samuelWilliams99/SmartKnob/electronics/view_base/view_base.kicad_pcb

## KiCad design electronics/view_base/view_base.kicad_pcb (2026-04-20)

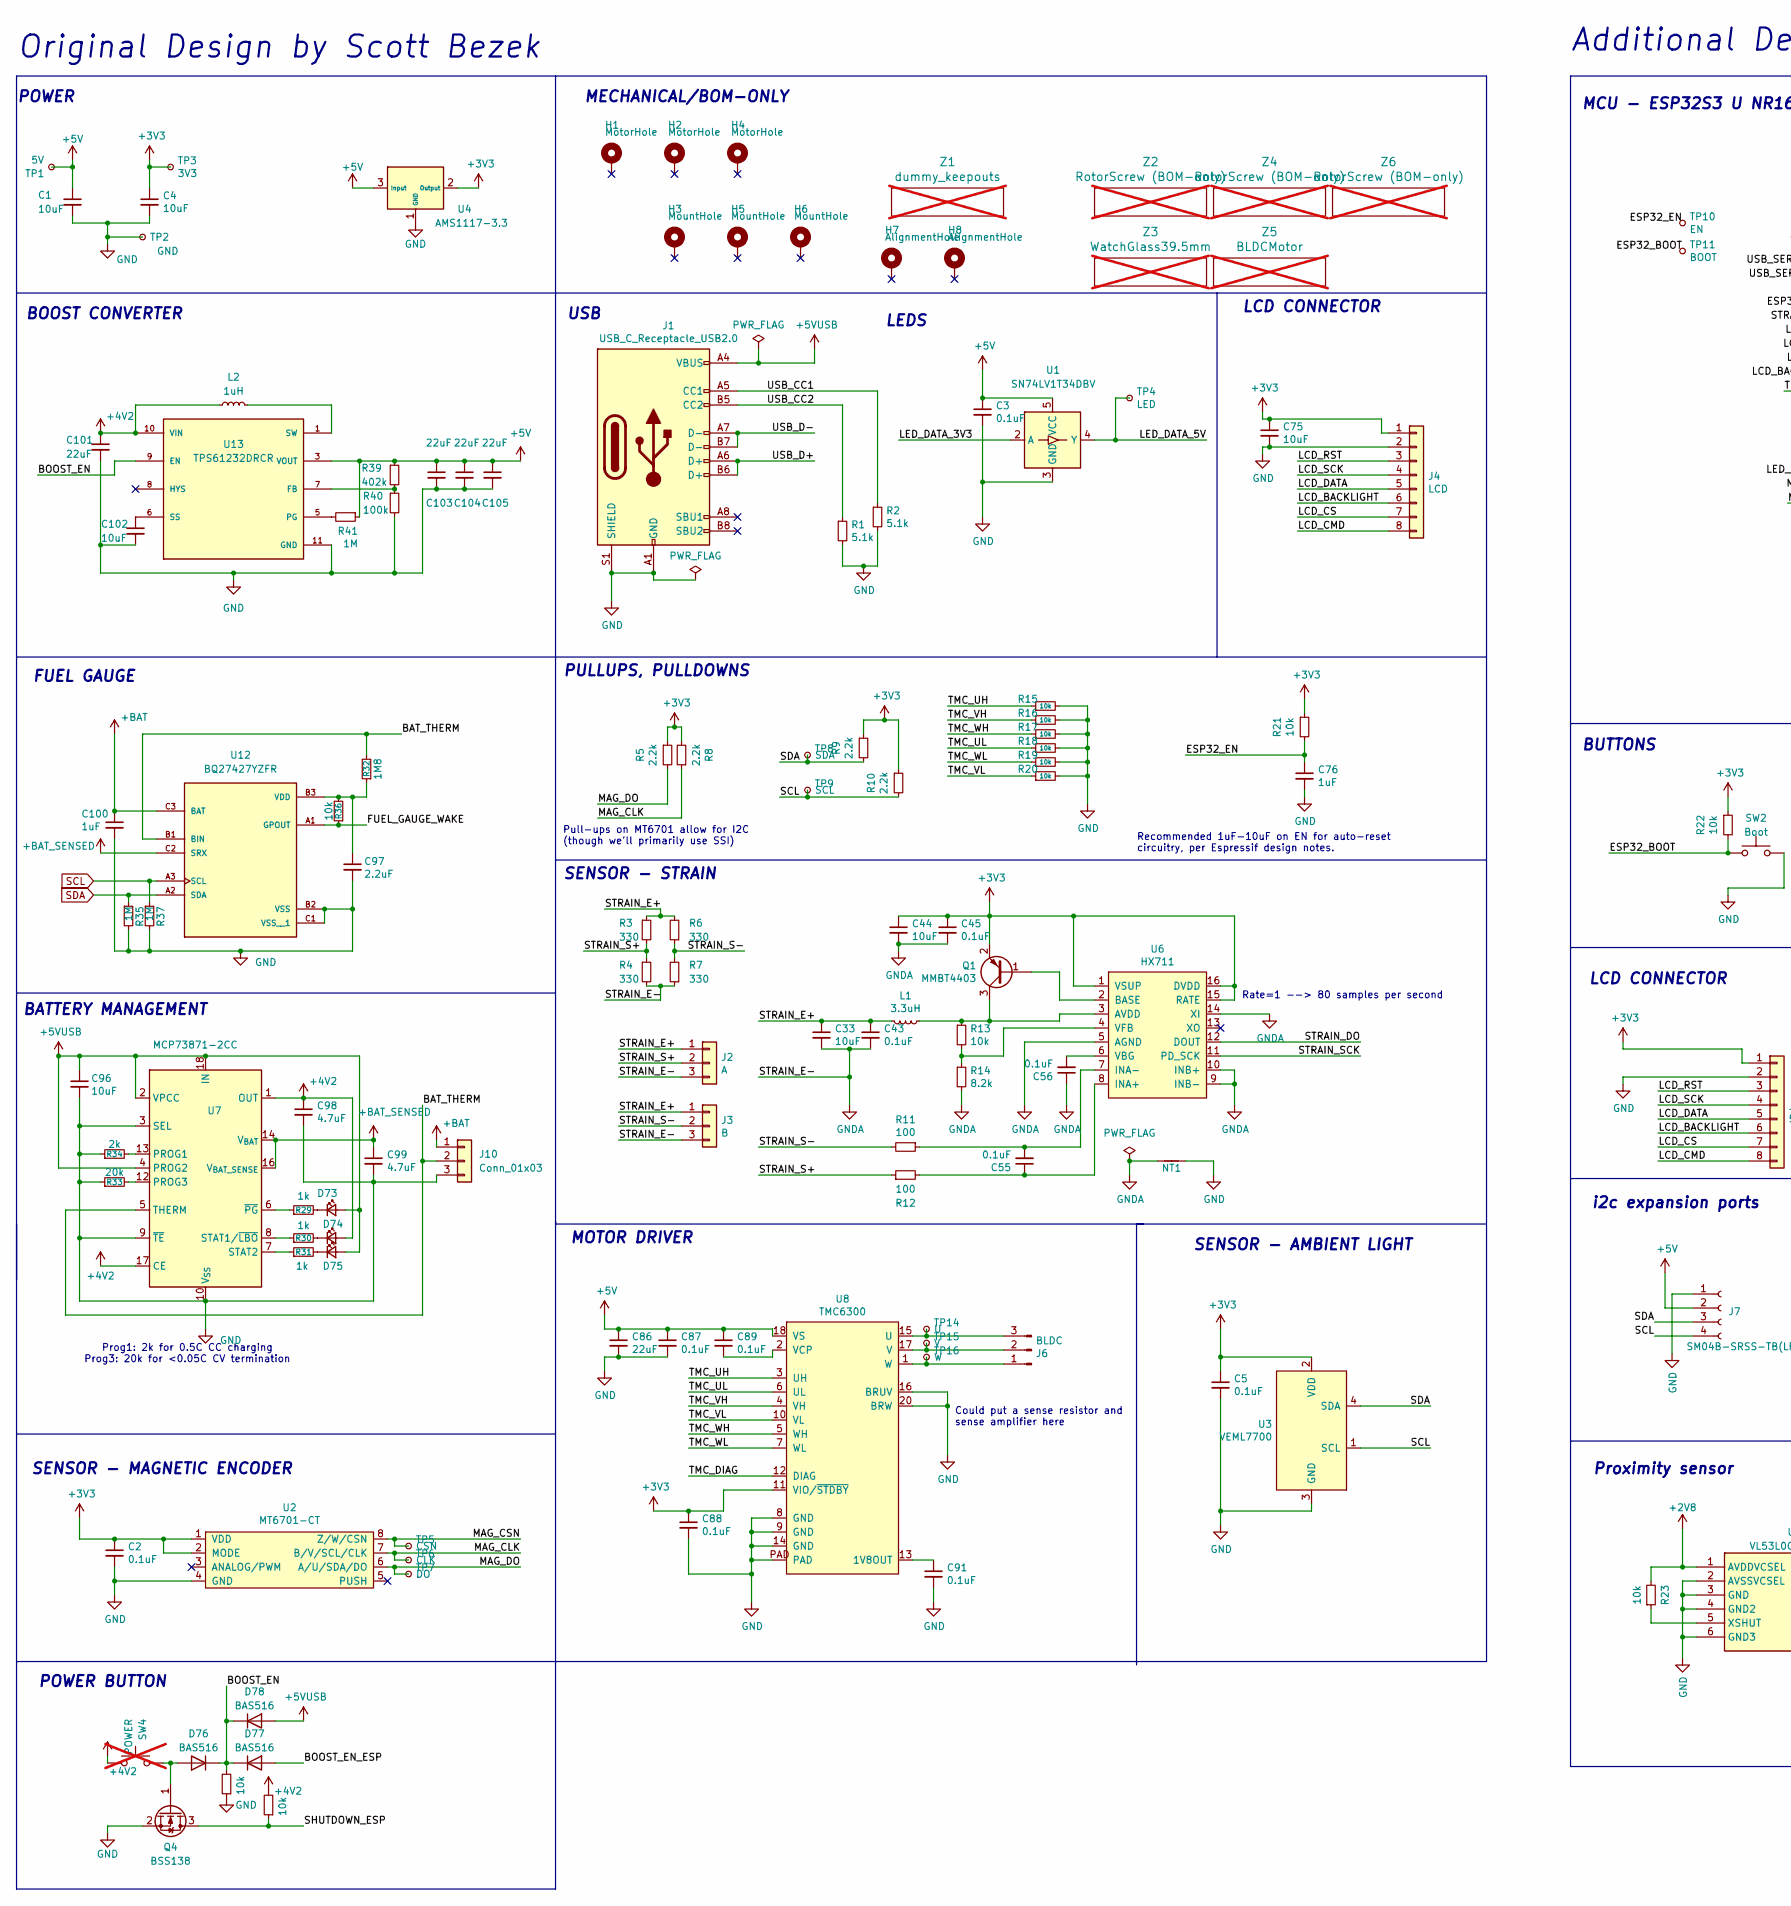
[picture p1: schematic view_base.kicad_sch, SmartKnob DevKit Base, part in row 1, column 1]

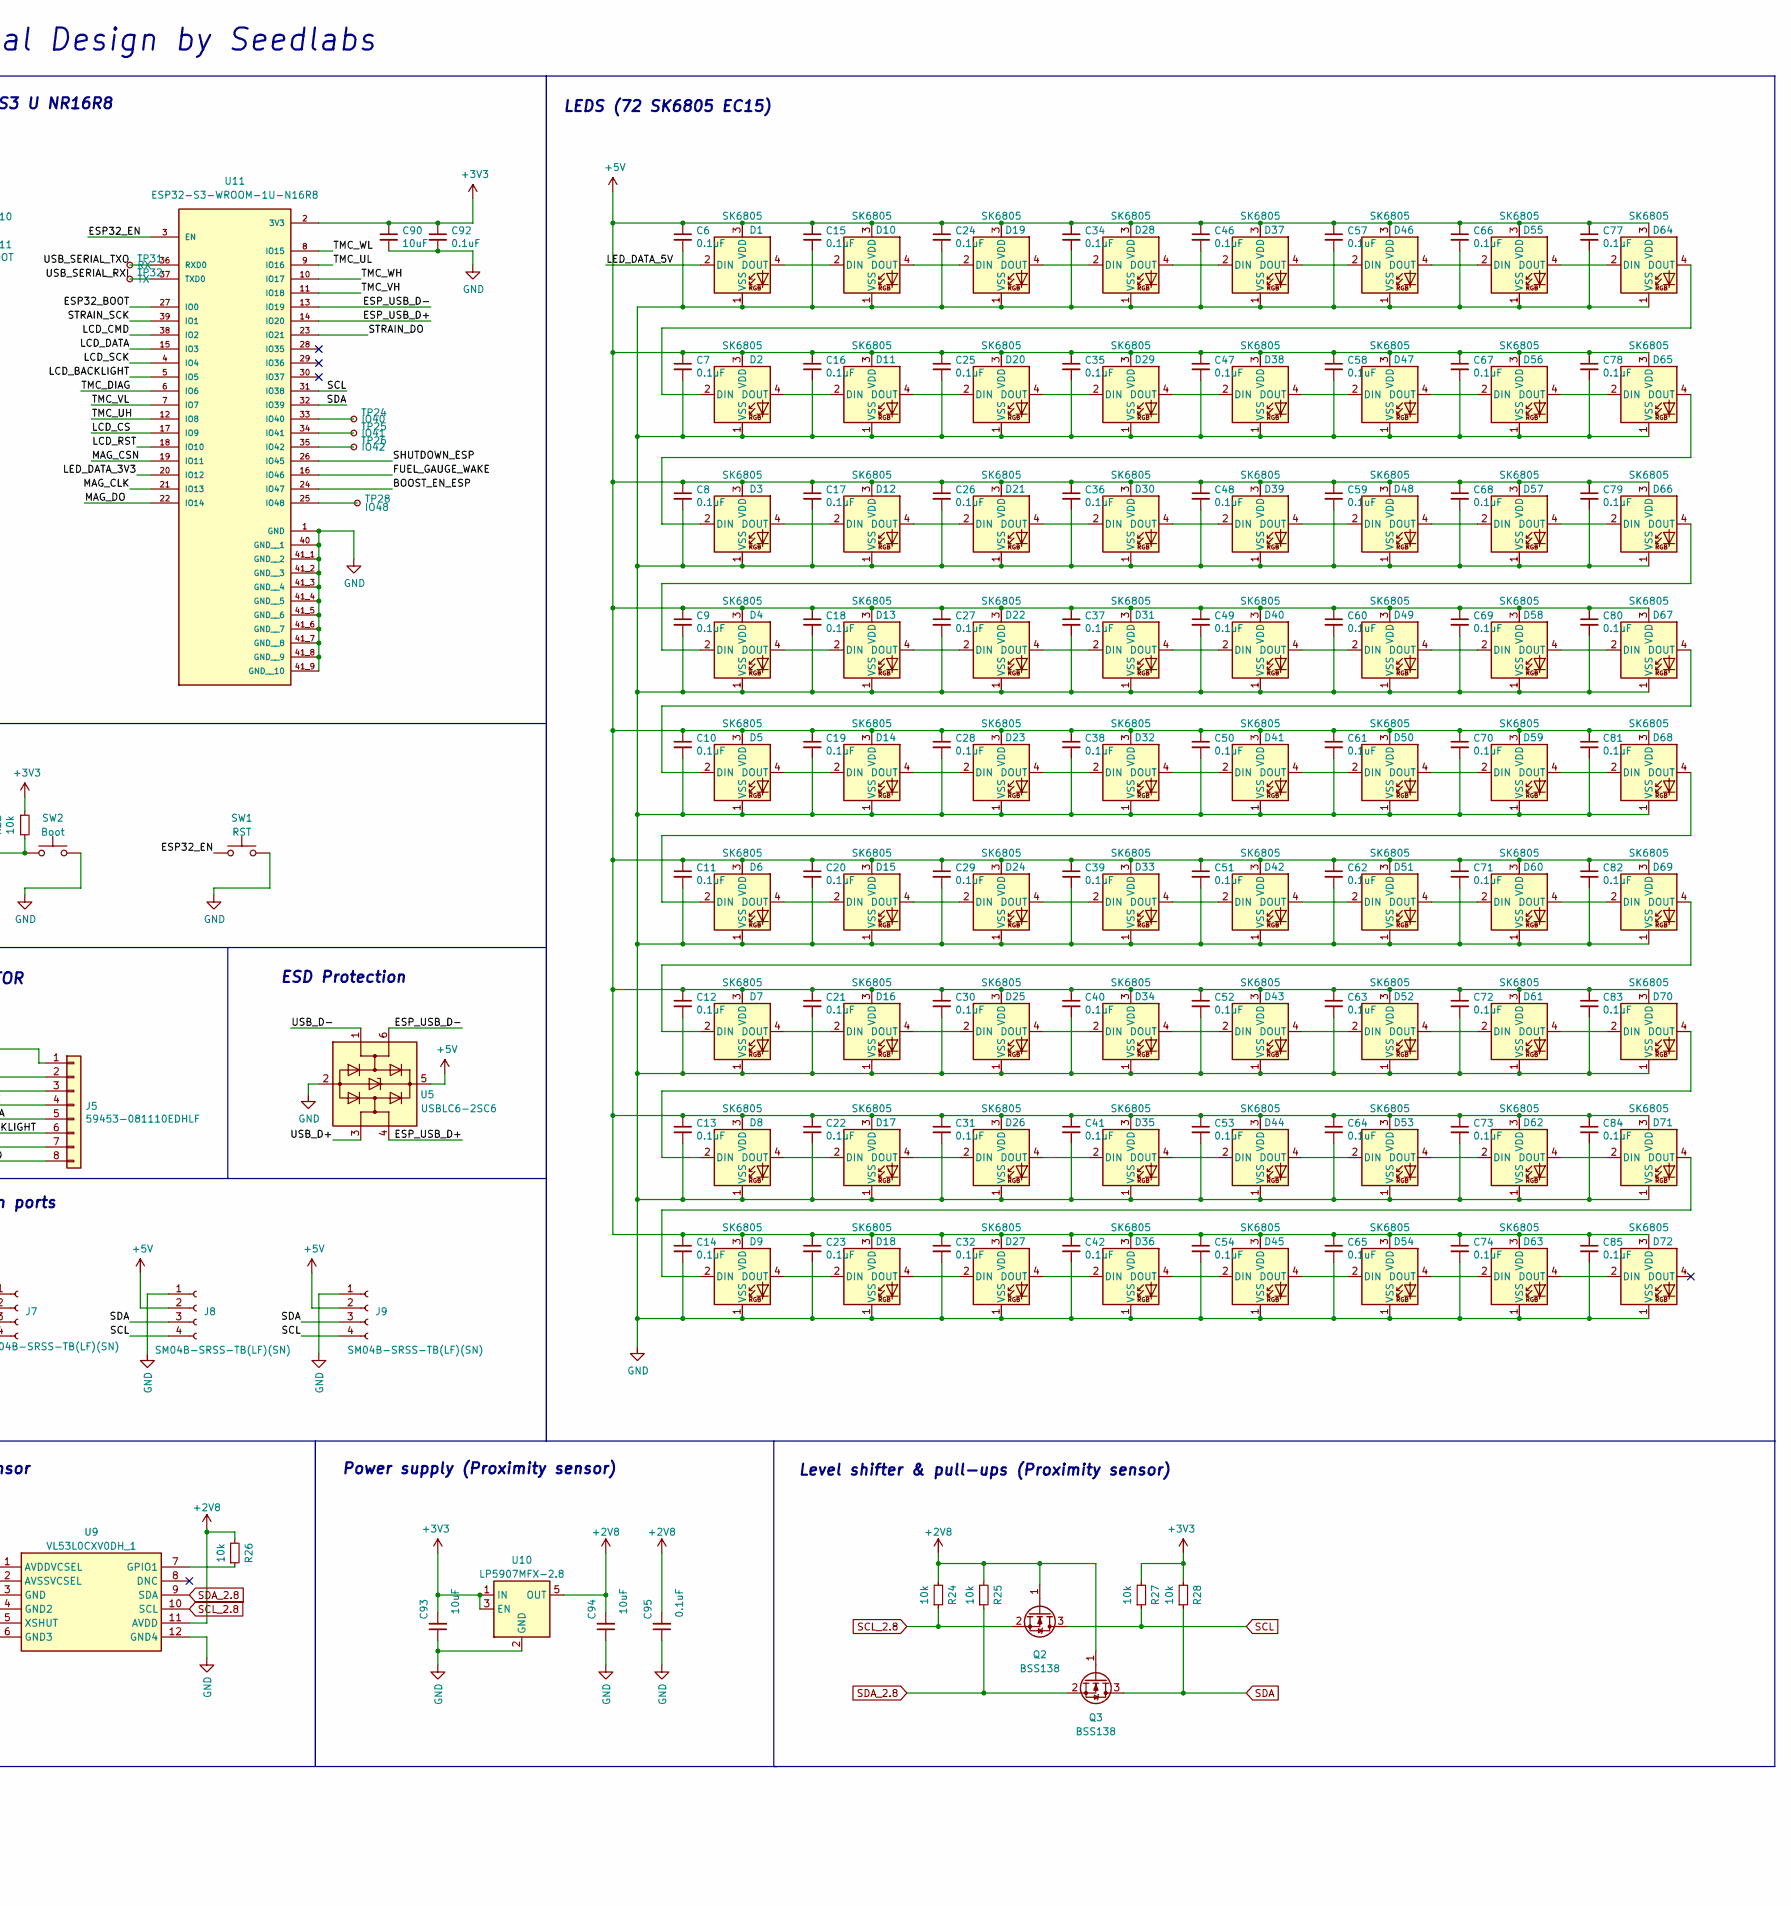
[picture p2: schematic view_base.kicad_sch, SmartKnob DevKit Base, part in row 1, column 2]

Parts:
C1, C4, C33, C44, C75, C90, C96: 10uF; C_0805_2012Metric; LCSC C15850
C2, C3, C5, C43, C45, C55, C56, C87, C88, C89, C91, C92, C95: 0.1uF; C_0603_1608Metric; LCSC C1591
C6, C7, C8, C9, C10, C11, C12, C13, C14, C15, C16, C17, C18, C19, C20, C21, C22, C23, C24, C25, C26, C27, C28, C29, C30, C31, C32, C34, C35, C36, C37, C38, C39, C40, C41, C42, C46, C47, C48, C49, C50, C51, C52, C53, C54, C57, C58, C59, C60, C61, C62, C63, C64, C65, C66, C67, C68, C69, C70, C71, C72, C73, C74, C77, C78, C79, C80, C81, C82, C83, C84, C85: 0.1uF; C_0402_1005Metric; LCSC C83056
C76: 1uF; C_0603_1608Metric; Mouser 187-CL10A105KA8NNNC
C86, C101, C103, C104, C105: 22uF; C_0805_2012Metric; LCSC C98190
C93, C94, C102: 10uF; C_0603_1608Metric; LCSC C38898
C97: 2.2uF; C_0805_2012Metric; LCSC C2228260
C98, C99: 4.7uF; C_0805_2012Metric; LCSC C1779
C100: 1uF; C_0805_2012Metric; LCSC C520051
D1, D2, D3, D4, D5, D6, D7, D8, D9, D10, D11, D12, D13, D14, D15, D16, D17, D18, D19, D20, D21, D22, D23, D24, D25, D26, D27, D28, D29, D30, D31, D32, D33, D34, D35, D36, D37, D38, D39, D40, D41, D42, D43, D44, D45, D46, D47, D48, D49, D50, D51, D52, D53, D54, D55, D56, D57, D58, D59, D60, D61, D62, D63, D64, D65, D66, D67, D68, D69, D70, D71, D72: SK6805; LED_SK6812_EC15_1.5x1.5mm; LCSC C2890035
D73: Blue; LED_0805_2012Metric; LCSC C2293
D74: Green; LED_0805_2012Metric; LCSC C2297
D75: Red; LED_0805_2012Metric; LCSC C2295
D76, D77, D78: BAS516; D_SOD-523; LCSC C10037
H1, H2, H4: MotorHole; MountingHole_M1.6; LCSC C2931389
H3, H5, H6: MountHole; MountingHole_2.2mm_M2_ISO7380_Pad_NonVirtual; LCSC C2911210 or C2911532 (screw), C2961595 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
H7, H8: AlignmentHole; MountingHole_2.2mm_M2_ISO7380_Pad_NonVirtual
J1: USB_C_Receptacle_USB2.0; USB4510_NoPaste; LCSC C428463
J2: A; SolderPads_2mm_3_STRAIN
J3: B; SolderPads_2mm_3_STRAIN
J4: LCD; SolderPads_2mm_8
J5: 59453-081110EDHLF; Amphenol FCI FPC 8 pin 0.5 pitch; Mouser 649-59453081110EDHLF
J6: BLDC; 532610371; LCSC C293630
J7, J8, J9: SM04B-SRSS-TB(LF)(SN); JST_SH_SM04B-SRSS-TB_1x04-1MP_P1.00mm_Horizontal; Mouser 485-4208
J10: Conn_01x03; JST_PH_S3B-PH-K_1x03_P2.00mm_Horizontal; LCSC C545716
L1: 3.3uH; L_0805_2012Metric; LCSC C307744
L2: 1uH; L_0603_1608Metric
NT1: NetTie_2; NetTie-2_SMD_Pad0.5mm
Q1: MMBT4403; SOT-23; LCSC C78864
Q2, Q3, Q4: BSS138; SOT-23; LCSC C2874697
R1, R2: 5.1k; R_0603_1608Metric; LCSC C105580
R3, R4, R6, R7: 330; R_2512_6332Metric; LCSC C19866
R5, R8, R9, R10: 2.2k; R_0603_1608Metric; LCSC C4190
R11, R12: 100; R_0603_1608Metric; LCSC C319953
R13, R15, R16, R17, R18, R19, R20, R21, R22, R23, R24, R25, R26, R27, R28, R36, R42, R43: 10k; R_0603_1608Metric; LCSC C98220
R14: 8.2k; R_0603_1608Metric; LCSC C114637
R29, R30, R31: 1k; R_0603_1608Metric; LCSC C21190
R32: 1M8; R_0603_1608Metric; LCSC C22356606
R33: 20k; R_0805_2012Metric_Pad1.20x1.40mm_HandSolder; LCSC C4328
R34: 2k; R_0805_2012Metric_Pad1.20x1.40mm_HandSolder; LCSC C17604
R35, R37, R41: 1M; R_0603_1608Metric; LCSC C22935
R39: 402k; R_0603_1608Metric; LCSC C23048
R40: 100k; R_0603_1608Metric; LCSC C25803
SW1: RST; SW_SPST_PTS810; LCSC C116501
SW2: Boot; SW_SPST_PTS810; LCSC C116501
SW4: POWER; TestPoint_2Pads_Pitch2.54mm_Drill0.8mm; LCSC C116501; not fitted
TP1: 5V; TestPoint_Pad_D2.0mm
TP2: GND; TestPoint_Pad_D2.0mm
TP3: 3V3; TestPoint_Pad_D2.0mm
TP4: LED; TestPoint_Pad_D2.0mm
TP5: CSN; TestPoint_Pad_D2.0mm
TP6: CLK; TestPoint_Pad_D2.0mm
TP7: DO; TestPoint_Pad_D2.0mm
TP8: SDA; TestPoint_Pad_D2.0mm
TP9: SCL; TestPoint_Pad_D2.0mm
TP10: EN; TestPoint_Pad_D2.0mm
TP11: BOOT; TestPoint_Pad_D2.0mm
TP14: U; TestPoint_Pad_D2.0mm
TP15: V; TestPoint_Pad_D2.0mm
TP16: W; TestPoint_Pad_D2.0mm
TP24: IO40; TestPoint_Pad_D2.0mm
TP25: IO41; TestPoint_Pad_D2.0mm
TP26: IO42; TestPoint_Pad_D2.0mm
TP28: IO48; TestPoint_Pad_D2.0mm
TP31: RX; TestPoint_Pad_D2.0mm
TP32: TX; TestPoint_Pad_D2.0mm
U1: SN74LV1T34DBV; SOT-23-5; LCSC C100024
U2: MT6701-CT; SOIC-8_3.9x4.9mm_P1.27mm; LCSC C2856764
U3: VEML7700; VEML7700-TOP; Digikey VEML7700-TT
U4: AMS1117-3.3; SOT-223-3_TabPin2_GndOutIn; LCSC C6186
U5: USBLC6-2SC6; SOT-23-6; LCSC C7519
U6: HX711; SOIC-16_3.9x9.9mm_P1.27mm; LCSC C43656
U7: MCP73871-2CC; QFN-20-1EP_4x4mm_P0.5mm_EP2.5x2.5mm
U8: TMC6300; QFN-20-1EP_3x3mm_P0.4mm_EP1.65x1.65mm_ThermalVias_LargerVia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; Digikey TMC6300-LA-T
U9: VL53L0CXV0DH_1; LGA12_1; Mouser Part Number 511-VL53L0CXV0DH/1
U10: LP5907MFX-2.8; SOT-23-5; Mouser 595-LP5907MFX-2.8NPB
U11: ESP32-S3-WROOM-1U-N16R8; XCVR_ESP32-S3-WROOM-1U-N16R8; PARTREV v1.1; JLCPCB Position Offset 0,-0.5
U12: BQ27427YZFR; Texas_DSBGA-9_1.62x1.58mm_Layout3x3_P0.5mm; PARTREV December 2022
U13: TPS61232DRCR; VREG_TPS61232DRCR; PARTREV C
Z1: dummy_keepouts; ViewKeepouts3d; not fitted
Z2, Z4, Z6: RotorScrew (BOM-only); bom_only_no_pin; not fitted
Z3: WatchGlass39.5mm; bom_only_no_pin; not fitted
Z5: BLDCMotor; bom_only_no_pin; not fitted

Connections:
+2V8: C94.2, C95.2, Q2.1 (G), Q3.1 (G), R23.2, R24.2, R25.2, R26.2, U9.1 (AVDDVCSEL), U9.11 (AVDD), U10.5 (OUT)
+3V3: C2.1, C4.1, C5.1, C44.1, C45.1, C75.1, C88.1, C90.1, C92.1, C93.2, J4.1, J5.1, Q1.2 (E), R5.1, R8.2, R9.1, R10.1, R21.1, R22.1, R27.2, R28.2, TP3.1, U2.1 (VDD), U2.2 (MODE), U3.2 (VDD), U4.2 (Output), U6.1 (VSUP), U6.15 (RATE), U6.16 (DVDD), U8.11 (VIO/~STDBY), U10.1 (IN), U10.3 (EN), U11.2 (3V3)
+4V2: C98.1, C101.1, D74.2 (A), L2.1, R42.2, SW4.1, U7.1 (OUT), U7.17 (CE), U7.20 (OUT), U13.10 (VIN)
+5V: C1.1, C3.1, C6.1, C7.1, C8.1, C9.1, C10.1, C11.1, C12.1, C13.1, C14.1, C15.1, C16.1, C17.1, C18.1, C19.1, C20.1, C21.1, C22.1, C23.1, C24.1, C25.1, C26.1, C27.1, C28.1, C29.1, C30.1, C31.1, C32.1, C34.1, C35.1, C36.1, C37.1, C38.1, C39.1, C40.1, C41.1, C42.1, C46.1, C47.1, C48.1, C49.1, C50.1, C51.1, C52.1, C53.1, C54.1, C57.1, C58.1, C59.1, C60.1, C61.1, C62.1, C63.1, C64.1, C65.1, C66.1, C67.1, C68.1, C69.1, C70.1, C71.1, C72.1, C73.1, C74.1, C77.1, C78.1, C79.1, C80.1, C81.1, C82.1, C83.1, C84.1, C85.1, C86.1, C87.1, C89.1, C103.1, C104.1, C105.1, D1.3 (VDD), D2.3 (VDD), D3.3 (VDD), D4.3 (VDD), D5.3 (VDD), D6.3 (VDD), D7.3 (VDD), D8.3 (VDD), D9.3 (VDD), D10.3 (VDD), D11.3 (VDD), D12.3 (VDD), D13.3 (VDD), D14.3 (VDD), D15.3 (VDD), D16.3 (VDD), D17.3 (VDD), D18.3 (VDD), D19.3 (VDD), D20.3 (VDD), D21.3 (VDD), D22.3 (VDD), D23.3 (VDD), D24.3 (VDD), D25.3 (VDD), D26.3 (VDD), D27.3 (VDD), D28.3 (VDD), D29.3 (VDD), D30.3 (VDD), D31.3 (VDD), D32.3 (VDD), D33.3 (VDD), D34.3 (VDD), D35.3 (VDD), D36.3 (VDD), D37.3 (VDD), D38.3 (VDD), D39.3 (VDD), D40.3 (VDD), D41.3 (VDD), D42.3 (VDD), D43.3 (VDD), D44.3 (VDD), D45.3 (VDD), D46.3 (VDD), D47.3 (VDD), D48.3 (VDD), D49.3 (VDD), D50.3 (VDD), D51.3 (VDD), D52.3 (VDD), D53.3 (VDD), D54.3 (VDD), D55.3 (VDD), D56.3 (VDD), D57.3 (VDD), D58.3 (VDD), D59.3 (VDD), D60.3 (VDD), D61.3 (VDD), D62.3 (VDD), D63.3 (VDD), D64.3 (VDD), D65.3 (VDD), D66.3 (VDD), D67.3 (VDD), D68.3 (VDD), D69.3 (VDD), D70.3 (VDD), D71.3 (VDD), D72.3 (VDD), J7.2, J8.2, J9.2, R39.1, R41.1, TP1.1, U1.5 (VCC), U4.3 (Input), U5.5 (VBUS), U8.18 (VS), U13.3 (VOUT), U13.4 (VOUT)
+5VUSB: C96.1, D73.2 (A), D75.2 (A), D78.2 (A), J1.A4 (VBUS), J1.A9 (VBUS), J1.B4 (VBUS), J1.B9 (VBUS), U7.2 (VPCC), U7.4 (PROG2), U7.18 (IN), U7.19 (IN)
+BAT: C100.1, J10.1, U12.C3 (BAT)
+BAT_SENSED: C99.1, U7.14 (V_{BAT}), U7.15 (V_{BAT}), U7.16 (V_{BAT_SENSE}), U12.C2 (SRX)
/BAT_THERM: J10.2, R32.2, U7.5 (THERM), U12.B1 (BIN)
/BOOST_EN: D76.1 (K), D77.1 (K), D78.1 (K), R43.2, U13.9 (EN)
/BOOST_EN_ESP: D77.2 (A), U11.24 (IO47)
/ESP32_BOOT: R22.2, SW2.1, TP11.1, U11.27 (IO0)
/ESP32_EN: C76.1, R21.2, SW1.1, TP10.1, U11.3 (EN)
/ESP_USB_D+: U5.4 (I/O2), U11.14 (IO20)
/ESP_USB_D-: U5.6 (I/O1), U11.13 (IO19)
/FUEL_GAUGE_WAKE: R36.1, U11.16 (IO46), U12.A1 (GPOUT)
/LCD_BACKLIGHT: J4.6, J5.6, U11.5 (IO5)
/LCD_CMD: J4.8, J5.8, U11.38 (IO2)
/LCD_CS: J4.7, J5.7, U11.17 (IO9)
/LCD_DATA: J4.5, J5.5, U11.15 (IO3)
/LCD_RST: J4.3, J5.3, U11.18 (IO10)
/LCD_SCK: J4.4, J5.4, U11.4 (IO4)
/LED_DATA_3V3: U1.2 (A), U11.20 (IO12)
/LED_DATA_5V: D1.2 (DIN), TP4.1, U1.4 (Y)
/MAG_CLK: R8.1, TP6.1, U2.7 (B/V/SCL/CLK), U11.21 (IO13)
/MAG_CSN: TP5.1, U2.8 (Z/W/CSN), U11.19 (IO11)
/MAG_DO: R5.2, TP7.1, U2.6 (A/U/SDA/DO), U11.22 (IO14)
/SHUTDOWN_ESP: Q4.3 (D), R42.1, U11.26 (IO45)
/STRAIN_DO: U6.12 (DOUT), U11.23 (IO21)
/STRAIN_E+: C33.1, C43.1, J2.1, J3.1, L1.2, R3.1, R6.2
/STRAIN_S+: J2.2, R3.2, R4.1, R12.1
/STRAIN_S-: J3.2, R6.1, R7.2, R11.2
/STRAIN_SCK: U6.11 (PD_SCK), U11.39 (IO1)
/TMC_DIAG: U8.12 (DIAG), U11.6 (IO6)
/TMC_UH: R15.1, U8.3 (UH), U11.12 (IO8)
/TMC_UL: R18.1, U8.6 (UL), U11.9 (IO16)
/TMC_VH: R16.1, U8.4 (VH), U11.11 (IO18)
/TMC_VL: R20.1, U8.10 (VL), U11.7 (IO7)
/TMC_WH: R17.1, U8.5 (WH), U11.10 (IO17)
/TMC_WL: R19.1, U8.7 (WL), U11.8 (IO15)
/USB_CC1: J1.A5 (CC1), R2.1
/USB_CC2: J1.B5 (CC2), R1.1
/USB_D+: J1.A6 (D+), J1.B6 (D+), U5.3 (I/O2)
/USB_D-: J1.A7 (D-), J1.B7 (D-), U5.1 (I/O1)
/USB_SERIAL_RXI: TP32.1, U11.37 (TXD0)
/USB_SERIAL_TXO: TP31.1, U11.36 (RXD0)
GND: C1.2, C2.2, C3.2, C4.2, C5.2, C6.2, C7.2, C8.2, C9.2, C10.2, C11.2, C12.2, C13.2, C14.2, C15.2, C16.2, C17.2, C18.2, C19.2, C20.2, C21.2, C22.2, C23.2, C24.2, C25.2, C26.2, C27.2, C28.2, C29.2, C30.2, C31.2, C32.2, C34.2, C35.2, C36.2, C37.2, C38.2, C39.2, C40.2, C41.2, C42.2, C46.2, C47.2, C48.2, C49.2, C50.2, C51.2, C52.2, C53.2, C54.2, C57.2, C58.2, C59.2, C60.2, C61.2, C62.2, C63.2, C64.2, C65.2, C66.2, C67.2, C68.2, C69.2, C70.2, C71.2, C72.2, C73.2, C74.2, C75.2, C76.2, C77.2, C78.2, C79.2, C80.2, C81.2, C82.2, C83.2, C84.2, C85.2, C86.2, C87.2, C88.2, C90.2, C91.2, C92.2, C93.1, C94.1, C95.1, C96.2, C97.2, C98.2, C99.2, C100.2, C101.2, C102.2, C103.2, C104.2, C105.2, D1.1 (VSS), D2.1 (VSS), D3.1 (VSS), D4.1 (VSS), D5.1 (VSS), D6.1 (VSS), D7.1 (VSS), D8.1 (VSS), D9.1 (VSS), D10.1 (VSS), D11.1 (VSS), D12.1 (VSS), D13.1 (VSS), D14.1 (VSS), D15.1 (VSS), D16.1 (VSS), D17.1 (VSS), D18.1 (VSS), D19.1 (VSS), D20.1 (VSS), D21.1 (VSS), D22.1 (VSS), D23.1 (VSS), D24.1 (VSS), D25.1 (VSS), D26.1 (VSS), D27.1 (VSS), D28.1 (VSS), D29.1 (VSS), D30.1 (VSS), D31.1 (VSS), D32.1 (VSS), D33.1 (VSS), D34.1 (VSS), D35.1 (VSS), D36.1 (VSS), D37.1 (VSS), D38.1 (VSS), D39.1 (VSS), D40.1 (VSS), D41.1 (VSS), D42.1 (VSS), D43.1 (VSS), D44.1 (VSS), D45.1 (VSS), D46.1 (VSS), D47.1 (VSS), D48.1 (VSS), D49.1 (VSS), D50.1 (VSS), D51.1 (VSS), D52.1 (VSS), D53.1 (VSS), D54.1 (VSS), D55.1 (VSS), D56.1 (VSS), D57.1 (VSS), D58.1 (VSS), D59.1 (VSS), D60.1 (VSS), D61.1 (VSS), D62.1 (VSS), D63.1 (VSS), D64.1 (VSS), D65.1 (VSS), D66.1 (VSS), D67.1 (VSS), D68.1 (VSS), D69.1 (VSS), D70.1 (VSS), D71.1 (VSS), D72.1 (VSS), J1.A1 (GND), J1.A12 (GND), J1.B1 (GND), J1.B12 (GND), J1.S1 (SHIELD), J4.2, J5.2, J7.1, J8.1, J9.1, J10.3, NT1.2, Q4.2 (S), R1.2, R2.2, R15.2, R16.2, R17.2, R18.2, R19.2, R20.2, R33.1, R34.1, R35.2, R37.2, R40.2, R43.1, SW1.2, SW2.2, TP2.1, U1.3 (GND), U2.4 (GND), U3.3 (GND), U4.1 (GND), U5.2 (GND), U7.3 (SEL), U7.9 (~TE), U7.10 (V_{SS}), U7.11 (V_{SS}), U7.21 (V_{SS}), U8.8 (GND), U8.9 (GND), U8.14 (GND), U8.16 (BRUV), U8.20 (BRW), U8.PAD, U9.2 (AVSSVCSEL), U9.3 (GND), U9.4 (GND2), U9.6 (GND3), U9.12 (GND4), U10.2 (GND), U11.1 (GND), U11.40 (GND__1), U11.41_1 (GND__2), U11.41_2 (GND__3), U11.41_3 (GND__4), U11.41_4 (GND__5), U11.41_5 (GND__6), U11.41_6 (GND__7), U11.41_7 (GND__8), U11.41_8 (GND__9), U11.41_9 (GND__10), U12.B2 (VSS), U12.C1 (VSS__1), U13.11 (GND), U13.11_1 (GND), U13.11_2 (GND), U13.11_3 (GND), U13.11_4 (GND)
GNDA: C33.2, C43.2, C44.2, C45.2, C56.1, J2.3, J3.3, NT1.1, R4.2, R7.1, R14.2, U6.5 (AGND), U6.9 (INB-), U6.10 (INB+), U6.14 (XI)
unnamed: D1.4 (DOUT), D10.2 (DIN)
unnamed: D2.2 (DIN), D64.4 (DOUT)
unnamed: D3.2 (DIN), D65.4 (DOUT)
unnamed: D4.2 (DIN), D66.4 (DOUT)
unnamed: D5.2 (DIN), D67.4 (DOUT)
unnamed: D6.2 (DIN), D68.4 (DOUT)
unnamed: D10.4 (DOUT), D19.2 (DIN)
unnamed: D2.4 (DOUT), D11.2 (DIN)
unnamed: D11.4 (DOUT), D20.2 (DIN)
unnamed: D3.4 (DOUT), D12.2 (DIN)
unnamed: D12.4 (DOUT), D21.2 (DIN)
unnamed: D4.4 (DOUT), D13.2 (DIN)
unnamed: D13.4 (DOUT), D22.2 (DIN)
unnamed: D5.4 (DOUT), D14.2 (DIN)
unnamed: D14.4 (DOUT), D23.2 (DIN)
unnamed: D6.4 (DOUT), D15.2 (DIN)
unnamed: D15.4 (DOUT), D24.2 (DIN)
unnamed: D7.4 (DOUT), D16.2 (DIN)
unnamed: D16.4 (DOUT), D25.2 (DIN)
unnamed: D8.4 (DOUT), D17.2 (DIN)
unnamed: D17.4 (DOUT), D26.2 (DIN)
unnamed: D9.4 (DOUT), D18.2 (DIN)
unnamed: D18.4 (DOUT), D27.2 (DIN)
unnamed: D19.4 (DOUT), D28.2 (DIN)
unnamed: D20.4 (DOUT), D29.2 (DIN)
unnamed: D21.4 (DOUT), D30.2 (DIN)
unnamed: D22.4 (DOUT), D31.2 (DIN)
unnamed: D23.4 (DOUT), D32.2 (DIN)
unnamed: D24.4 (DOUT), D33.2 (DIN)
unnamed: D25.4 (DOUT), D34.2 (DIN)
unnamed: D26.4 (DOUT), D35.2 (DIN)
unnamed: D27.4 (DOUT), D36.2 (DIN)
unnamed: D28.4 (DOUT), D37.2 (DIN)
unnamed: D29.4 (DOUT), D38.2 (DIN)
unnamed: D30.4 (DOUT), D39.2 (DIN)
unnamed: D31.4 (DOUT), D40.2 (DIN)
unnamed: D32.4 (DOUT), D41.2 (DIN)
unnamed: D33.4 (DOUT), D42.2 (DIN)
unnamed: D34.4 (DOUT), D43.2 (DIN)
unnamed: D35.4 (DOUT), D44.2 (DIN)
unnamed: D36.4 (DOUT), D45.2 (DIN)
unnamed: D37.4 (DOUT), D46.2 (DIN)
unnamed: D38.4 (DOUT), D47.2 (DIN)
unnamed: D39.4 (DOUT), D48.2 (DIN)
unnamed: D40.4 (DOUT), D49.2 (DIN)
unnamed: D41.4 (DOUT), D50.2 (DIN)
unnamed: D42.4 (DOUT), D51.2 (DIN)
unnamed: D43.4 (DOUT), D52.2 (DIN)
unnamed: D44.4 (DOUT), D53.2 (DIN)
unnamed: D45.4 (DOUT), D54.2 (DIN)
unnamed: D46.4 (DOUT), D55.2 (DIN)
unnamed: D47.4 (DOUT), D56.2 (DIN)
unnamed: D48.4 (DOUT), D57.2 (DIN)
unnamed: D49.4 (DOUT), D58.2 (DIN)
unnamed: D50.4 (DOUT), D59.2 (DIN)
unnamed: D51.4 (DOUT), D60.2 (DIN)
unnamed: D52.4 (DOUT), D61.2 (DIN)
unnamed: D53.4 (DOUT), D62.2 (DIN)
unnamed: D54.4 (DOUT), D63.2 (DIN)
unnamed: D55.4 (DOUT), D64.2 (DIN)
unnamed: D56.4 (DOUT), D65.2 (DIN)
unnamed: D57.4 (DOUT), D66.2 (DIN)
unnamed: D58.4 (DOUT), D67.2 (DIN)
unnamed: D59.4 (DOUT), D68.2 (DIN)
unnamed: D60.4 (DOUT), D69.2 (DIN)
unnamed: D61.4 (DOUT), D70.2 (DIN)
unnamed: D62.4 (DOUT), D71.2 (DIN)
unnamed: D63.4 (DOUT), D72.2 (DIN)
unnamed: D7.2 (DIN), D69.4 (DOUT)
unnamed: D8.2 (DIN), D70.4 (DOUT)
unnamed: D9.2 (DIN), D71.4 (DOUT)
unnamed: D73.1 (K), R29.2
unnamed: D74.1 (K), R30.2
unnamed: D75.1 (K), R31.2
unnamed: D76.2 (A), Q4.1 (G), SW4.2
unnamed: J6.1, TP16.1, U8.1 (W)
unnamed: J6.2, TP15.1, U8.17 (V)
unnamed: J6.3, TP14.1, U8.15 (U)
unnamed: Q1.1 (B), U6.2 (BASE)
unnamed: L1.1, Q1.3 (C), R13.1, U6.3 (AVDD)
unnamed: C55.1, R12.2, U6.8 (INA+)
unnamed: C55.2, R11.1, U6.7 (INA-)
unnamed: C56.2, U6.6 (VBG)
unnamed: R13.2, R14.1, U6.4 (VFB)
unnamed: R34.2, U7.13 (PROG1)
unnamed: R33.2, U7.12 (PROG3)
unnamed: R30.1, U7.8 (STAT1/~LBO)
unnamed: R31.1, U7.7 (STAT2)
unnamed: R29.1, U7.6 (~PG)
unnamed: C91.1, U8.13 (1V8OUT)
unnamed: C89.2, U8.2 (VCP)
unnamed: R26.1, U9.7 (GPIO1)
unnamed: R23.1, U9.5 (XSHUT)
unnamed: TP24.1, U11.33 (IO40)
unnamed: TP25.1, U11.34 (IO41)
unnamed: TP26.1, U11.35 (IO42)
unnamed: TP28.1, U11.25 (IO48)
unnamed: C97.1, R32.1, R36.2, U12.B3 (VDD)
unnamed: R39.2, R40.1, U13.7 (FB)
unnamed: R41.2, U13.5 (PG)
unnamed: C102.1, U13.6 (SS)
SCL: J7.4, J8.4, J9.4, Q2.3 (D), R10.2, R27.1, R37.1, TP9.1, U3.1 (SCL), U11.31 (IO38), U12.A3 (SCL)
SCL_2.8: Q2.2 (S), R24.1, U9.10 (SCL)
SDA: J7.3, J8.3, J9.3, Q3.3 (D), R9.2, R28.1, R35.1, TP8.1, U3.4 (SDA), U11.32 (IO39), U12.A2 (SDA)
SDA_2.8: Q3.2 (S), R25.1, U9.9 (SDA)
SW: L2.2, U13.1 (SW), U13.2 (SW)

Notes on the sheet:
POWER
Could put a sense resistor and sense amplifier here
MCU - ESP32S3 U NR16R8
SENSOR - MAGNETIC ENCODER
MOTOR DRIVER
MECHANICAL/BOM-ONLY
Prog1: 2k for 0.5C CC charging Prog3: 20k for <0.05C CV termination
Pull-ups on MT6701 allow for I2C (though we'll primarily use SSI)
Rate=1 --> 80 samples per second
Additional Design by Seedlabs
Proximity sensor
SENSOR - AMBIENT LIGHT
Power supply (Proximity sensor)
BOOST CONVERTER
Original Design by Scott Bezek
Recommended 1uF-10uF on EN for auto-reset circuitry, per Espressif design notes.
BATTERY MANAGEMENT
POWER BUTTON
USB
SENSOR - STRAIN
LEDS
LEDS (72 SK6805 EC15)
BUTTONS
PULLUPS, PULLDOWNS
LCD CONNECTOR
i2c expansion ports
ESD Protection
Level shifter & pull-ups (Proximity sensor)
FUEL GAUGE

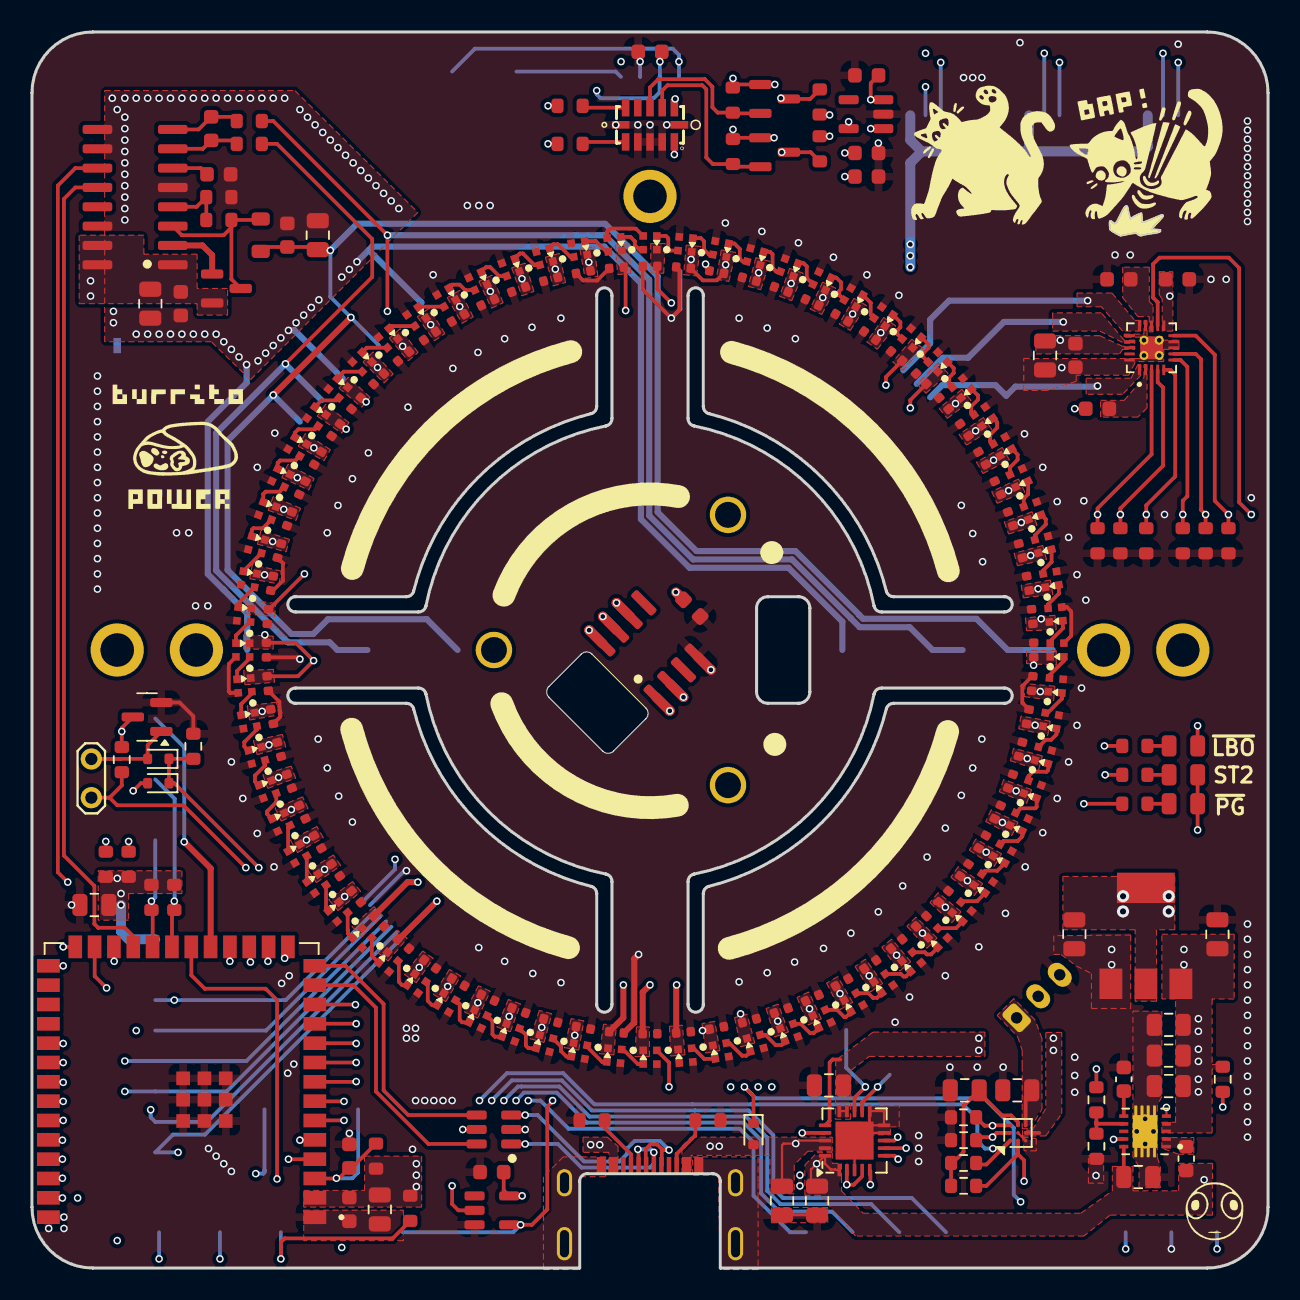
[picture p3: board view_base.kicad_pcb from above]

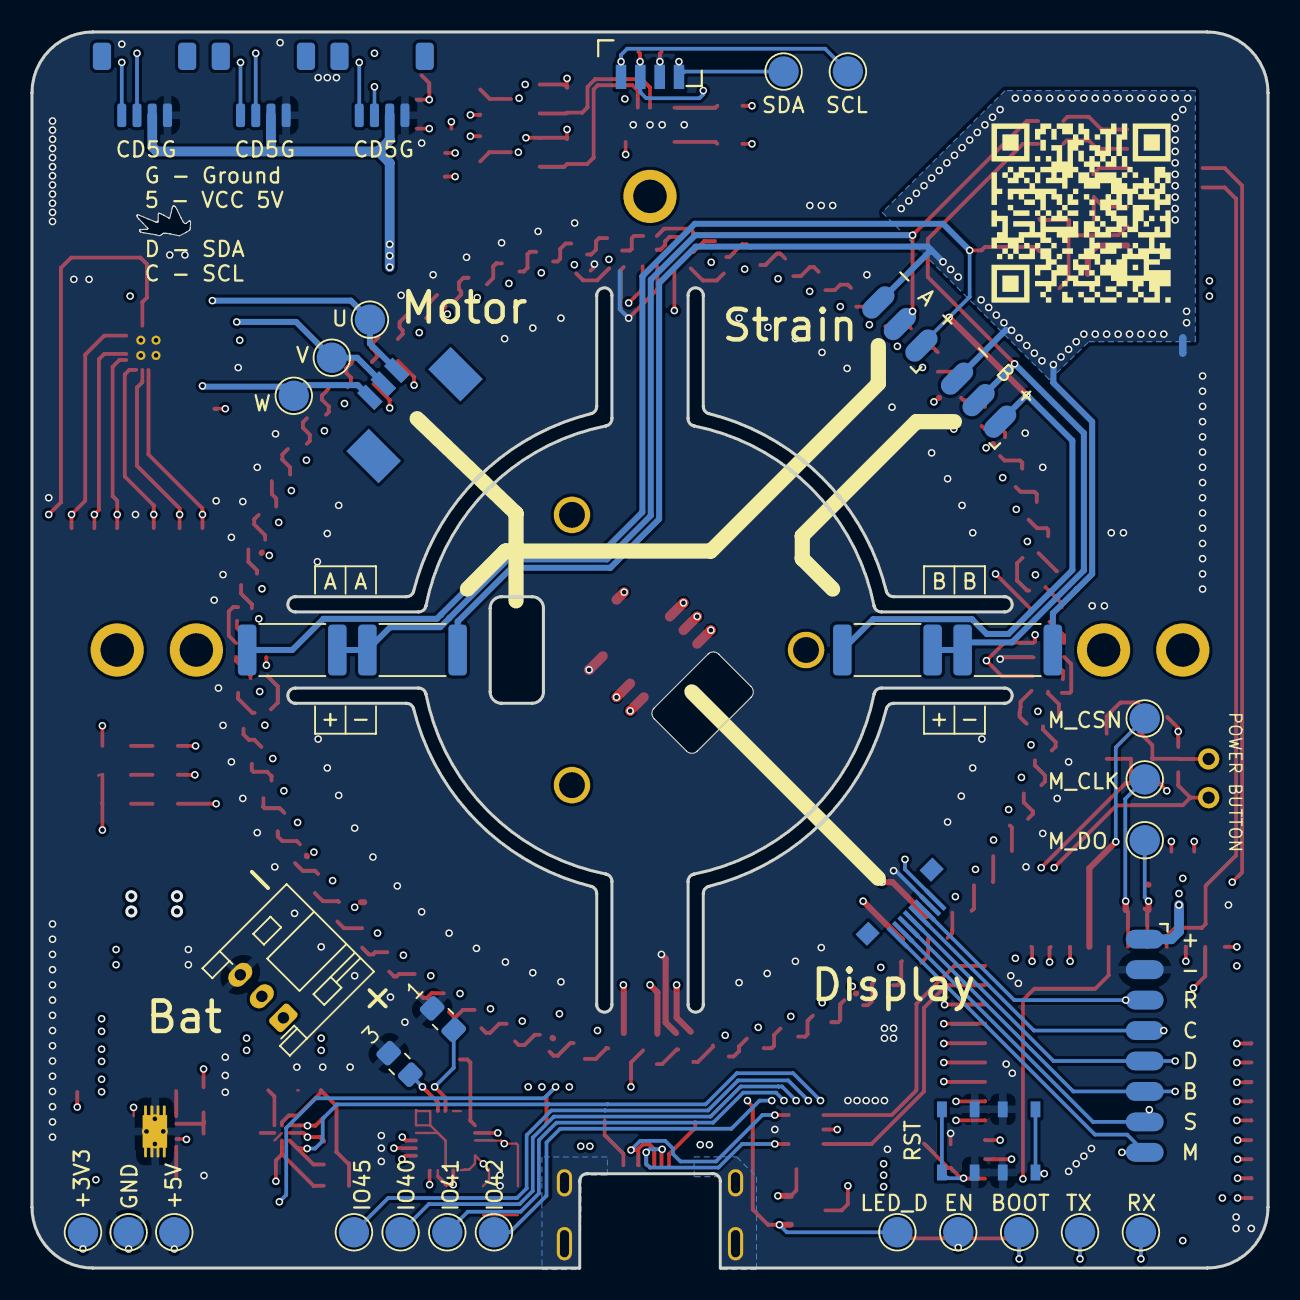
[picture p4: board view_base.kicad_pcb from below]

Board: 4 copper layers, 81.2 x 81.2 mm, 291 parts (39 on the bottom side), 153 nets.
