samuelWilliams99/SmartKnob/(commit log)

2025-11-08 Remove production
    [bom.csv, designators.csv, positions.csv]
2025-11-08 Program battery values
    [view_base.kicad_sch]
2025-11-08 Swap battery to 3pin connector
    [view_base.kicad_sch]
2025-11-08 Add models for missing components, sync pcb
    [view_base.kicad_pcb, view_base.kicad_sch]
2025-11-10 Move motor controller
    [view_base.kicad_pcb]
2025-11-13 Route boost converter off board
    [view_base.kicad_pcb, view_base.kicad_sch]
2026-03-17 Layout battery controller and fuel gauge
    [view_base - Copy.kicad_pcb, view_base.kicad_pcb, view_base.kicad_sch]
2026-03-17 start positioning battery components
    [view_base.kicad_pcb]
2026-03-19 Put everything on the board
    [view_base.kicad_pcb, view_base.kicad_sch]
2026-03-20 Address DRC issues
    [view_base.kicad_pcb]
2026-03-20 Add battery status LED labels
    [view_base.kicad_pcb]
2026-03-20 Fix up zones a bit
    [view_base.kicad_pcb]
2026-03-21 Fixed charging termination resistor
    [view_base.kicad_pcb, view_base.kicad_sch]
2026-03-24 Address Torin review
    [view_base.kicad_pcb]
2026-03-24 Rotate battery connector
    [view_base.kicad_pcb]
2026-03-25 Remove wrong i2c pullups, cleanup planes a bit
    [view_base.kicad_pcb, view_base.kicad_sch]
2026-04-01 Update part numbers for everything
    [view_base.kicad_pcb, view_base.kicad_sch]
2026-04-02 Add parts for screen board
    [view_base.kicad_pcb, view_screen.kicad_pcb, view_screen.kicad_sch]
2026-04-04 Add hardware switch, bad resistor values
    [view_base.kicad_pcb, view_base.kicad_sch, view_screen.kicad_pcb]
2026-04-05 Fix some shit
    [view_base.kicad_pcb, view_base.kicad_sch]
2026-04-05 Small tweaks
    [view_base.kicad_pcb, view_base.kicad_sch]
2026-04-06 Cleanup silk
    [view_base.kicad_pcb]
2026-04-07 Move battery programming resistors to back
    [view_base.kicad_pcb, view_base.kicad_sch]
2026-04-07 Fill out battery resistor LCSC, move for easier soldering
    [view_base.kicad_pcb, view_base.kicad_sch]
2026-04-08 Wire up fuel gauge wakeup pin
    [view_base.kicad_pcb, view_base.kicad_sch]
2026-04-16 Add grounds, fix pins for power button
    [view_base.kicad_pcb, view_base.kicad_sch]
2026-04-16 Remove old labels, remove bad via
    [view_base.kicad_pcb]
2026-04-18 Add artwork!
    [view_base.kicad_pcb]
2026-04-18 Add footprint files and qr code
    [view_base.kicad_pcb]
2026-04-20 Remove C86 label
    [view_base.kicad_pcb]
2026-04-20 Fix part numbers, remove bad labels
    [view_base.kicad_pcb, view_base.kicad_sch]
